athanniss/capstone-hw/bj-magistrska.step

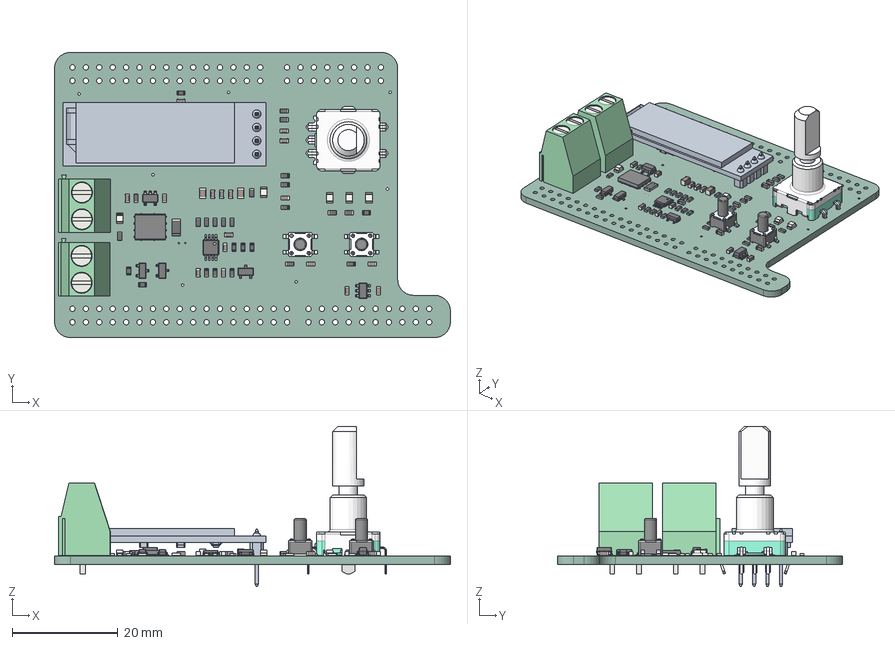
[picture p1: CAD file, 2025-01-03]
bj-magistrska.step
75.0 x 54.0 x 30.4 mm
R_0603_1608Metric x 34
TerminalBlock_Phoenix_MKDS_15_2_508_1x02_P508mm_Horizontal x 2
C_0603_1608Metric x 20
LED_0805_2012Metric x 5
L_0603_1608Metric
SOT_23_5
MSOP_8_3x3mm_P065mm x 2
PowerDI5060-8L
OLED 128 x 32 Display Assembly v4
SOT_23 x 3
R_1206_3216Metric
SOT_23_6
EC11E-15SW v3
C_0805_2012Metric x 2
PTS647SK70SMTR2LFS v2 x 2
_autosave-bj-magistrska_PCB
