athanniss/capstone-hw/bj-magistrska.kicad_pcb

## KiCad design bj-magistrska.kicad_pcb (2025-01-03)

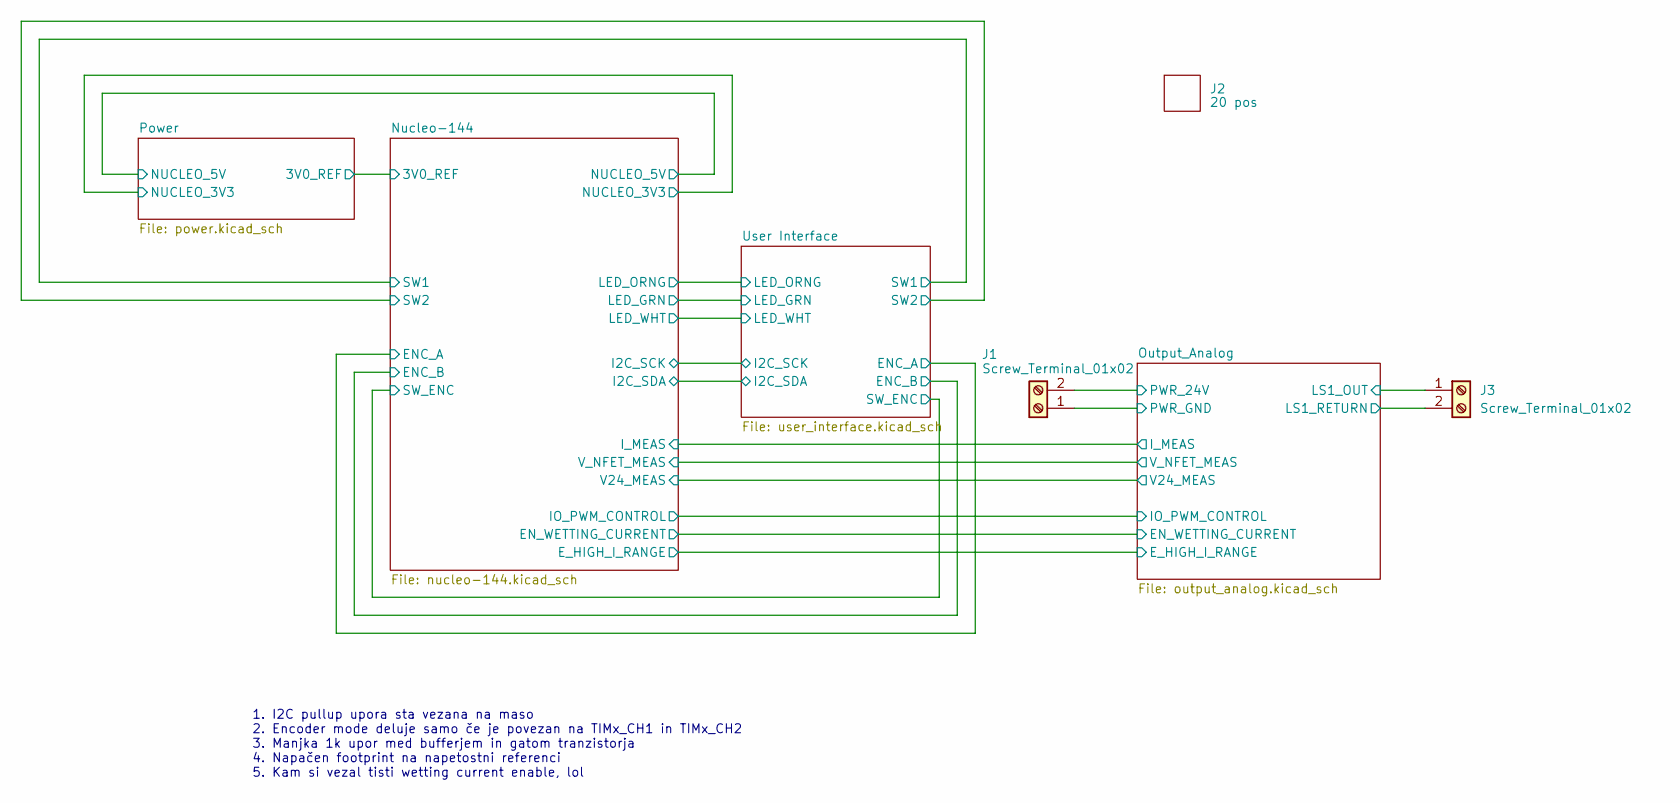
[picture p2: schematic bj-magistrska.kicad_sch]

Parts:
J1, J3: Screw_Terminal_01x02; TerminalBlock_Phoenix_MKDS-1,5-2-5.08_1x02_P5.08mm_Horizont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; Mfg. Part Number 1985904
J2: 20 pos; Mfg. Part Number PRPC020SACN-RC; Digikey no. S1131EC-20-ND

Connections:
/Output_Analog/LS1_OUT: J1.2, J3.1; also elsewhere on the board
/Output_Analog/LS1_RETURN: J3.2; also elsewhere on the board
/Output_Analog/PWR_GND: J1.1; also elsewhere on the board

Notes on the sheet:
1. I2C pullup upora sta vezana na maso 2. Encoder mode deluje samo če je povezan na TIMx_CH1 in TIMx_CH2 3. Manjka 1k upor med bufferjem in gatom tranzistorja 4. Napačen footprint na napetostni referenci 5. Kam si vezal tisti wetting current enable, lol

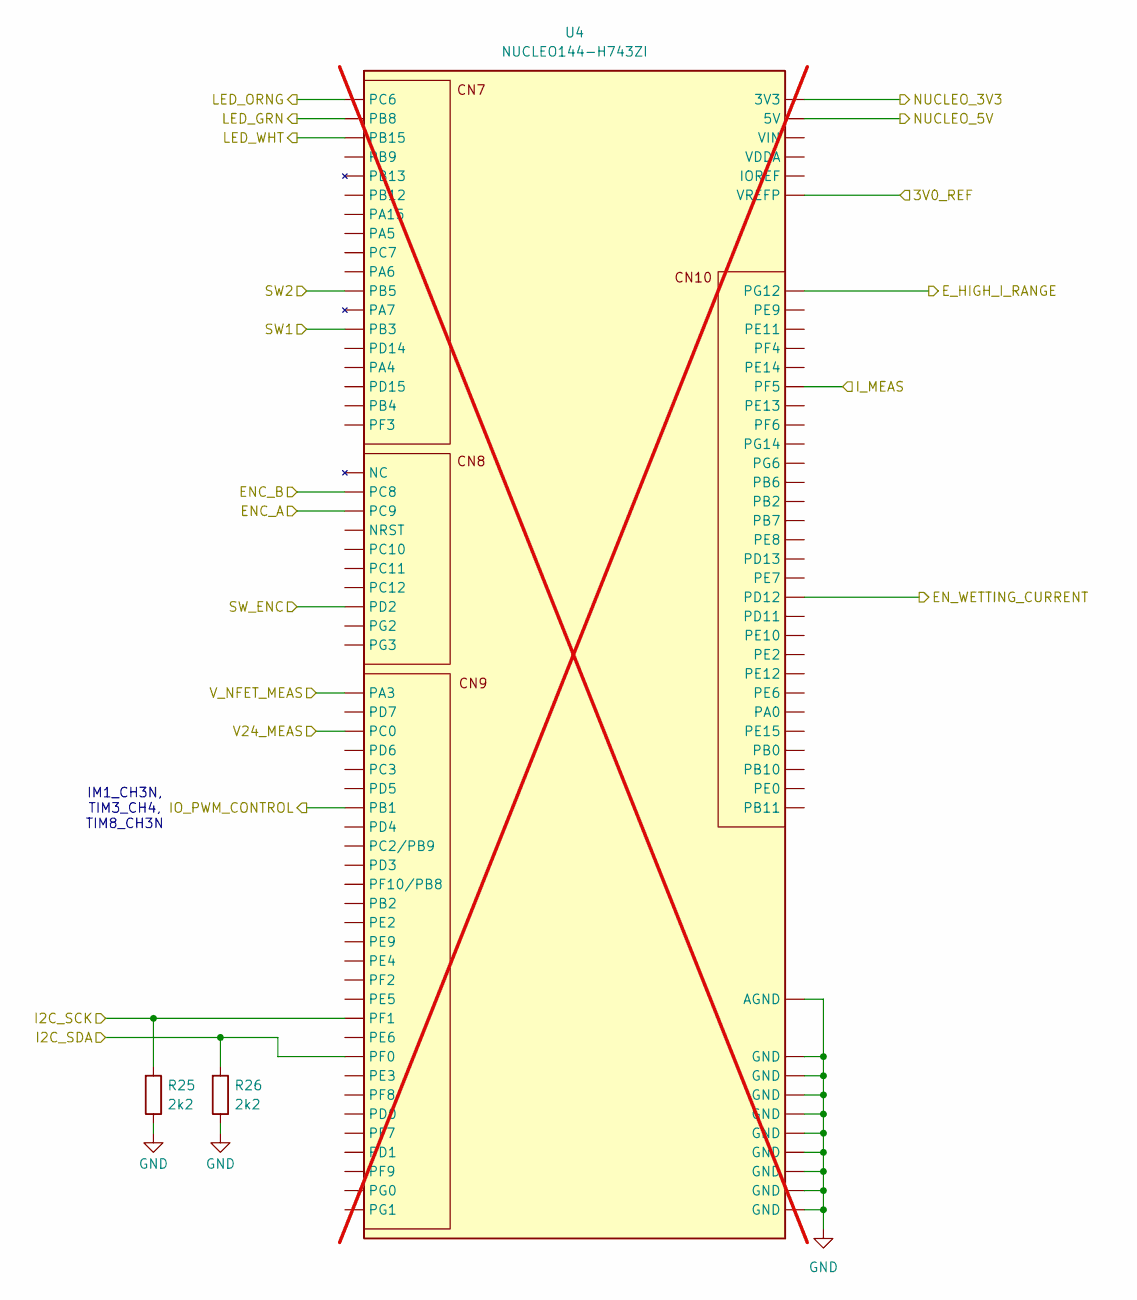
[picture p3: schematic nucleo-144.kicad_sch]

Parts:
R25, R26: 2k2; R_0603_1608Metric
U4: NUCLEO144-H743ZI; ST_Zio_Only_Connectors_144_STLink; not fitted

Connections:
+3V3: U4.CN8_7 (3V3); also elsewhere on the board
+5VD: U4.CN8_9 (5V); also elsewhere on the board
/Nucleo-144/3V0_REF: U4.CN7_6 (VREFP); also elsewhere on the board
/Nucleo-144/ENC_A: U4.CN8_4 (PC9); also elsewhere on the board
/Nucleo-144/ENC_B: U4.CN8_2 (PC8); also elsewhere on the board
/Nucleo-144/EN_WETTING_CURRENT: U4.CN10_21 (PD12); also elsewhere on the board
/Nucleo-144/E_HIGH_I_RANGE: U4.CN10_2 (PG12); also elsewhere on the board
/Nucleo-144/I2C_SCK: R25.1, U4.CN9_19 (PF1); also elsewhere on the board
/Nucleo-144/I2C_SDA: R26.1, U4.CN9_21 (PF0); also elsewhere on the board
/Nucleo-144/IO_PWM_CONTROL: U4.CN9_7 (РВ1); also elsewhere on the board
/Nucleo-144/I_MEAS: U4.CN10_9 (PF5); also elsewhere on the board
/Nucleo-144/LED_GRN: U4.CN7_2 (PB8); also elsewhere on the board
/Nucleo-144/LED_ORNG: U4.CN7_1 (PC6); also elsewhere on the board
/Nucleo-144/LED_WHT: U4.CN7_3 (PB15); also elsewhere on the board
/Nucleo-144/SW1: U4.CN7_15 (PB3); also elsewhere on the board
/Nucleo-144/SW2: U4.CN7_13 (PB5); also elsewhere on the board
/Nucleo-144/SW_ENC: U4.CN8_12 (PD2); also elsewhere on the board
/Nucleo-144/V24_MEAS: U4.CN9_3 (PC0); also elsewhere on the board
/Nucleo-144/V_NFET_MEAS: U4.CN9_1 (РАЗ); also elsewhere on the board
GND: R25.2, R26.2, U4.CN7_8 (GND), U4.CN8_11 (GND), U4.CN8_13 (GND), U4.CN9_12 (GND), U4.CN9_23 (GND), U4.CN10_3 (AGND), U4.CN10_5 (GND), U4.CN10_17 (GND), U4.CN10_22 (GND), U4.CN10_27 (GND); also elsewhere on the board

Notes on the sheet:
IM1_CH3N, TIM3_CH4, TIM8_CH3N

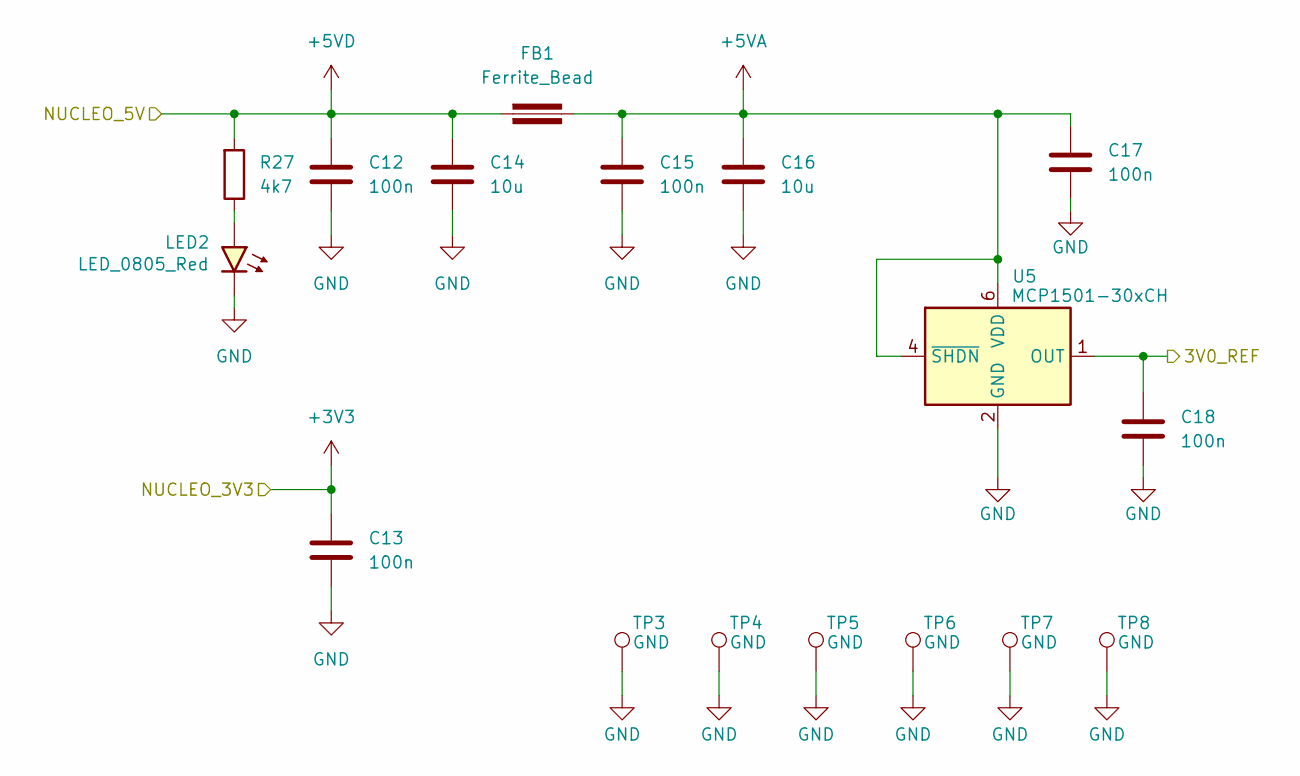
[picture p4: schematic power.kicad_sch]

Parts:
C12, C13, C15, C17, C18: 100n; C_0603_1608Metric
C14, C16: 10u; C_0805_2012Metric
FB1: Ferrite_Bead; Ferrite_0603_1608Metric
LED2: LED_0805_Red; LED_0805_2012Metric
R27: 4k7; R_0603_1608Metric
TP3, TP4, TP5, TP6, TP7, TP8: GND; TestPoint_THTPad_D1.0mm_Drill0.5mm
U5: MCP1501-30xCH; SOT-23-6; Mfg. Part Number MCP1501-30E/SN

Connections:
+3V3: C13.1; also elsewhere on the board
+5VA: C15.1, C16.1, C17.1, FB1.2, U5.4 (~SHDN), U5.6 (VDD); also elsewhere on the board
+5VD: C12.1, C14.1, FB1.1, R27.1; also elsewhere on the board
/Nucleo-144/3V0_REF: C18.1, U5.1 (OUT); also elsewhere on the board
GND: C12.2, C13.2, C14.2, C15.2, C16.2, C17.2, C18.2, LED2.1 (K), TP3.1, TP4.1, TP5.1, TP6.1, TP7.1, TP8.1, U5.2 (GND), U5.3 (GND), U5.5 (GND); also elsewhere on the board
unnamed: LED2.2 (A), R27.2

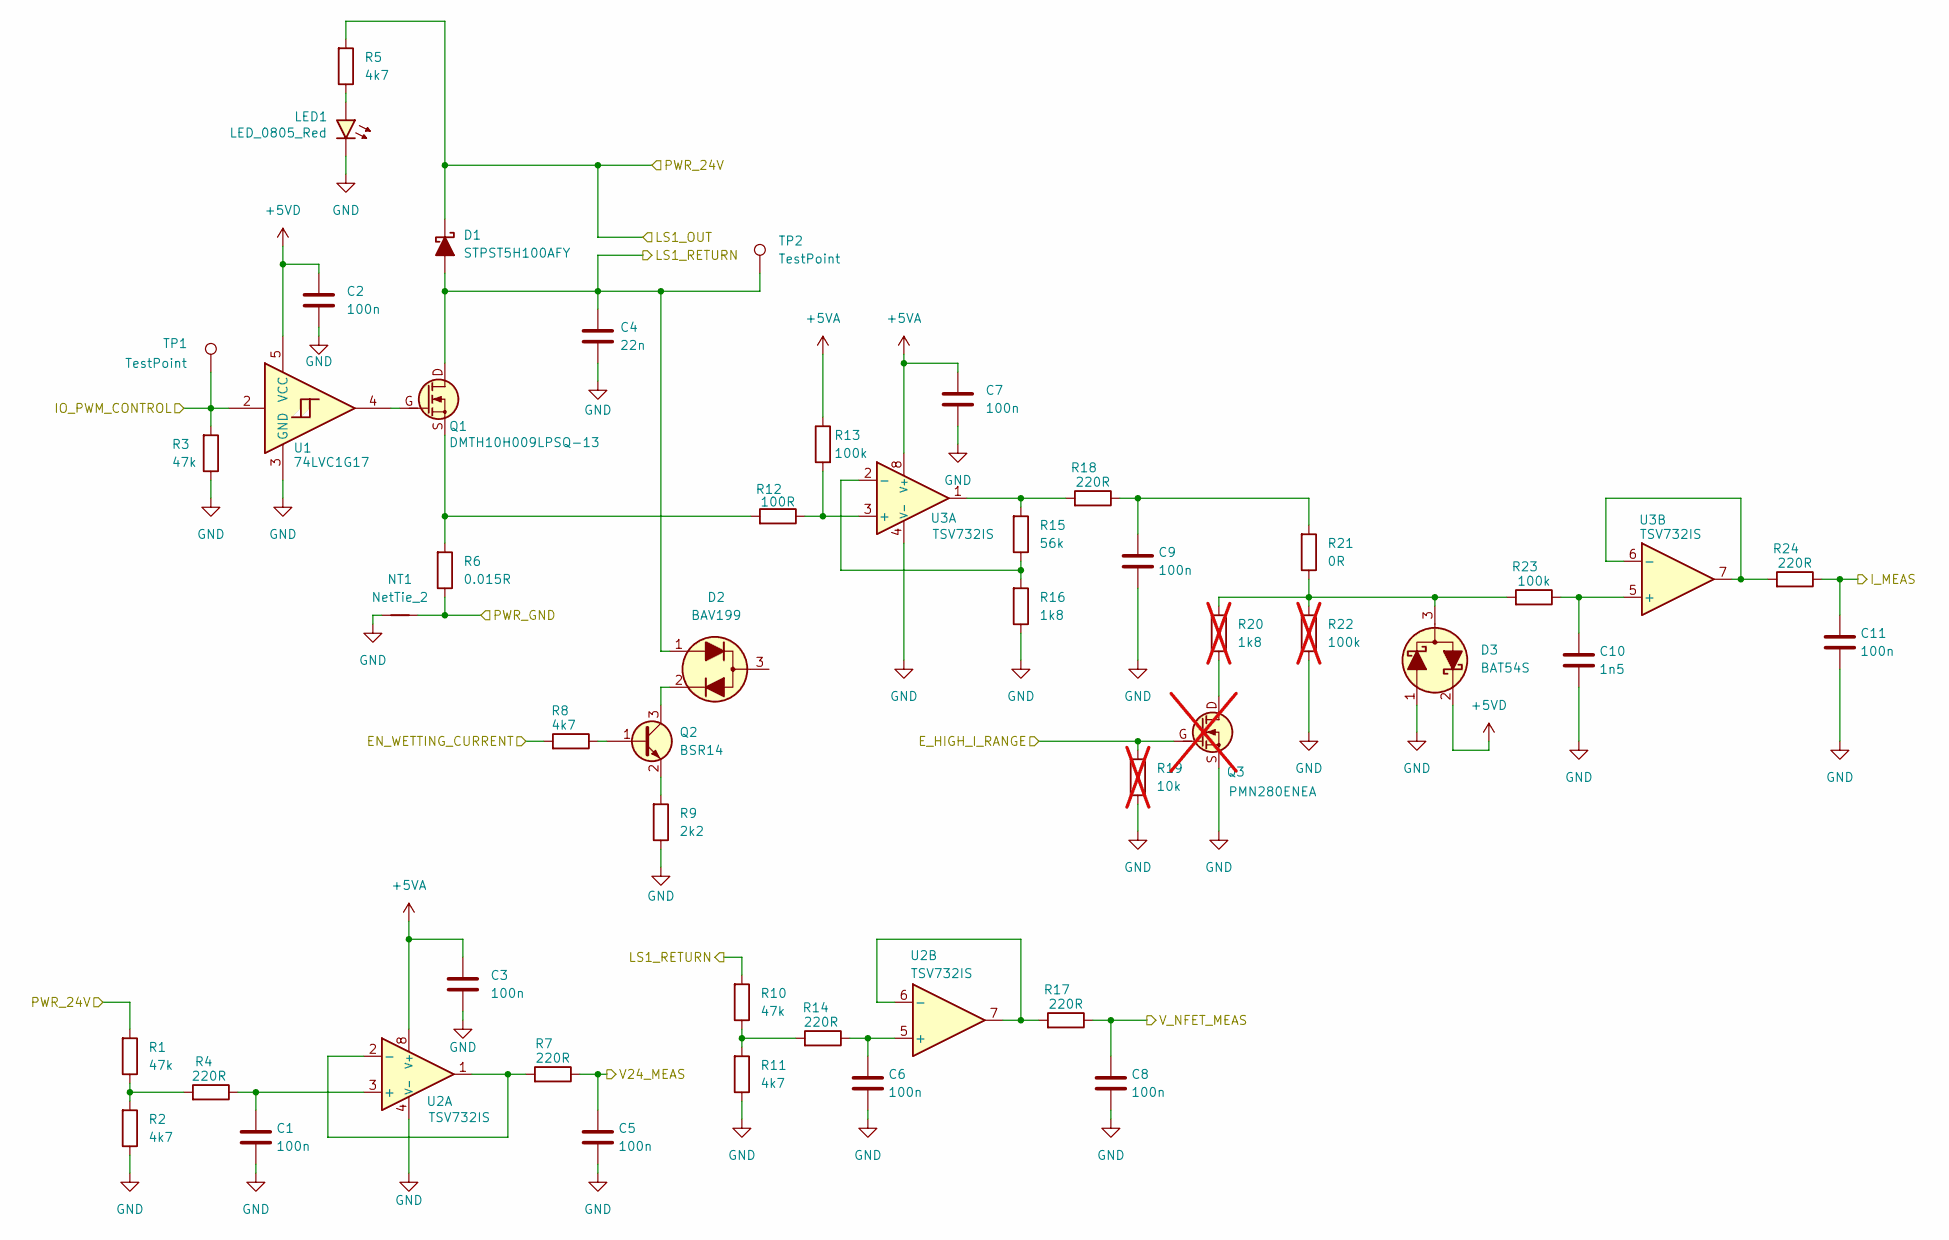
[picture p5: schematic output_analog.kicad_sch]

Parts:
C1, C2, C3, C5, C6, C7, C8, C9, C11: 100n; C_0603_1608Metric
C4: 22n; C_0603_1608Metric
C10: 1n5; C_0603_1608Metric
D1: STPST5H100AFY; D_SOD-128; Mfg. Part Number STPST5H100AFY
D2: BAV199; SOT-23; Mfg. Part Number BAV199
D3: BAT54S; SOT-23; Mfg. Part Number BAT54SHYT116
LED1: LED_0805_Red; LED_0805_2012Metric
NT1: NetTie_2; NetTie-2_THT_Pad0.3mm
Q1: DMTH10H009LPSQ-13; Diodes_PowerDI5060-8_ThermalVias; Mfg. Part Number DMTH10H009LPSQ-13
Q2: BSR14; SOT-23; Mfg. Part Number BSR14
Q3: PMN280ENEA; SC-74-6_1.5x2.9mm_P0.95mm; Mfg. Part Number PMN280ENEAX; not fitted
R1, R3, R10: 47k; R_0603_1608Metric
R2, R5, R8, R11: 4k7; R_0603_1608Metric
R4, R7, R14, R17, R18, R24: 220R; R_0603_1608Metric
R6: 0.015R; R_1206_3216Metric; Mfg. Part Number MFSA1206R0150FCM
R9: 2k2; R_0603_1608Metric
R12: 100R; R_0603_1608Metric
R13, R23: 100k; R_0603_1608Metric
R15: 56k; R_0603_1608Metric
R16: 1k8; R_0603_1608Metric
R19: 10k; R_0603_1608Metric; not fitted
R20: 1k8; R_0603_1608Metric; not fitted
R21: 0R; R_0603_1608Metric
R22: 100k; R_0603_1608Metric; not fitted
TP1, TP2: TestPoint; TestPoint_THTPad_D1.0mm_Drill0.5mm
U1: 74LVC1G17; SOT-23-5; Mfg. Part Number SN74LVC1G17DBVR
U2, U3: TSV732IS; MSOP-8_3x3mm_P0.65mm; Mfg. Part Number TSV732IST

Connections:
+5VA: C3.1, C7.1, R13.2, U2.8 (V+), U3.8 (V+); also elsewhere on the board
+5VD: C2.1, D3.2 (K), U1.5 (VCC); also elsewhere on the board
/Nucleo-144/EN_WETTING_CURRENT: R8.1; also elsewhere on the board
/Nucleo-144/E_HIGH_I_RANGE: Q3.G, R19.1; also elsewhere on the board
/Nucleo-144/IO_PWM_CONTROL: R3.1, TP1.1, U1.2; also elsewhere on the board
/Nucleo-144/I_MEAS: C11.1, R24.2; also elsewhere on the board
/Nucleo-144/V24_MEAS: C5.1, R7.2; also elsewhere on the board
/Nucleo-144/V_NFET_MEAS: C8.1, R17.2; also elsewhere on the board
/Output_Analog/LS1_OUT: D1.1 (K), R1.1, R5.1; also elsewhere on the board
/Output_Analog/LS1_RETURN: C4.1, D1.2 (A), D2.1 (A), Q1.D, R10.1, TP2.1; also elsewhere on the board
/Output_Analog/PWR_GND: NT1.2, R6.2; also elsewhere on the board
GND: C1.2, C2.2, C3.2, C4.2, C5.2, C6.2, C7.2, C8.2, C9.2, C10.2, C11.2, D3.1 (A), LED1.1 (K), NT1.1, Q3.S, R2.2, R3.2, R9.2, R11.2, R16.2, R19.2, R22.2, U1.3 (GND), U2.4 (V-), U3.4 (V-); also elsewhere on the board
unnamed: C9.1, R18.2, R21.1
unnamed: D2.2 (K), Q2.3 (C)
unnamed: D3.3 (C), R20.1, R21.2, R22.1, R23.1
unnamed: LED1.2 (A), R5.2
unnamed: Q1.G, U1.4
unnamed: Q1.S, R6.1, R12.1
unnamed: Q2.1 (B), R8.2
unnamed: Q2.2 (E), R9.1
unnamed: Q3.D, R20.2
unnamed: R1.2, R2.1, R4.1
unnamed: R10.2, R11.1, R14.1
unnamed: R15.1, R18.1, U3.1
unnamed: C1.1, R4.2, U2.3 (+)
unnamed: R7.1, U2.1, U2.2 (-)
unnamed: C6.1, R14.2, U2.5 (+)
unnamed: R17.1, U2.6 (-), U2.7
unnamed: R12.2, R13.1, U3.3 (+)
unnamed: R15.2, R16.1, U3.2 (-)
unnamed: C10.1, R23.2, U3.5 (+)
unnamed: R24.1, U3.6 (-), U3.7

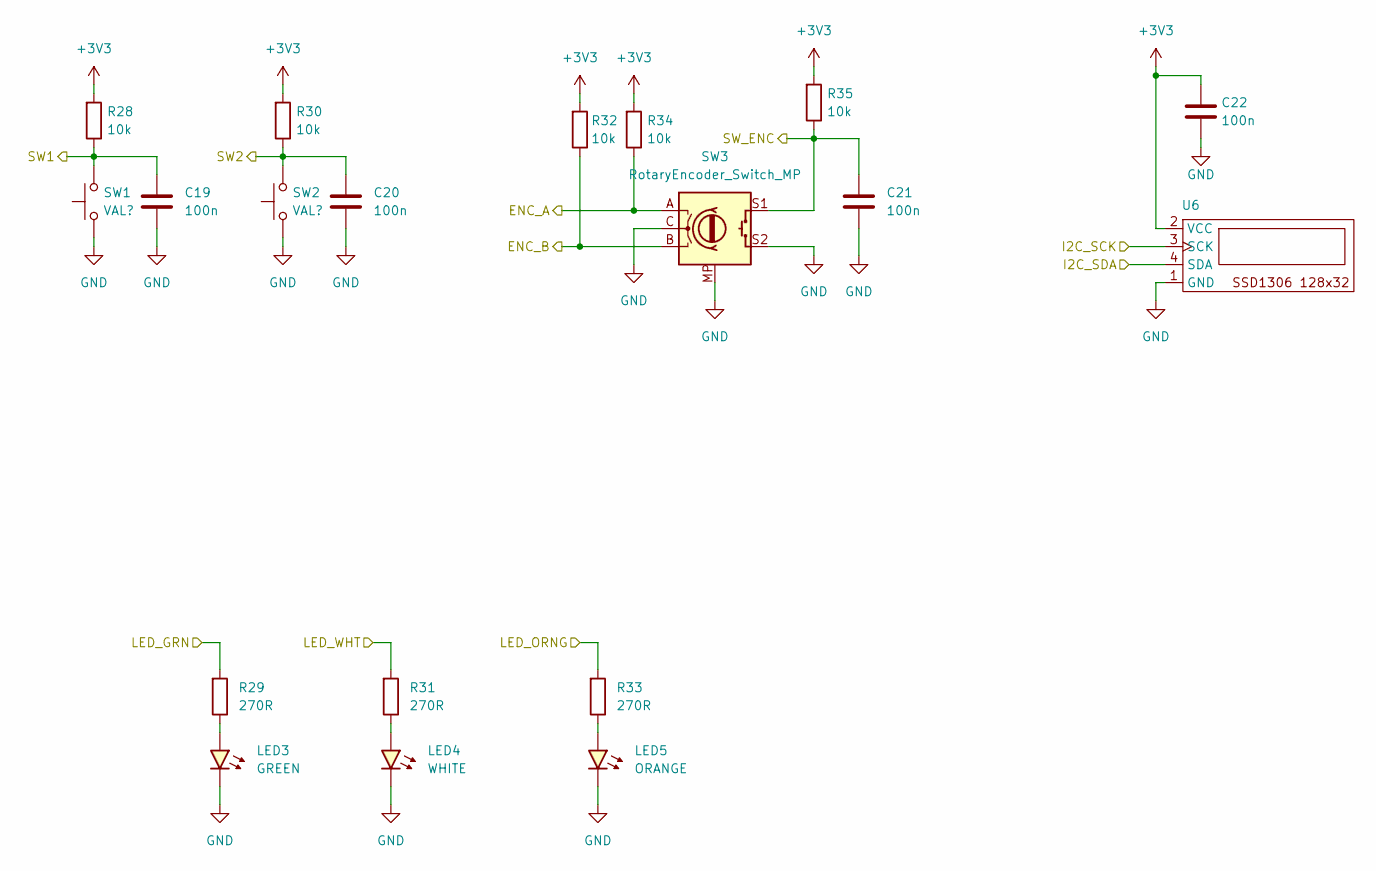
[picture p6: schematic user_interface.kicad_sch]

Parts:
C19, C20, C21, C22: 100n; C_0603_1608Metric
LED3: GREEN; LED_0805_2012Metric
LED4: WHITE; LED_0805_2012Metric
LED5: ORANGE; LED_0805_2012Metric
R28, R30, R32, R34, R35: 10k; R_0603_1608Metric
R29, R31, R33: 270R; R_0603_1608Metric
SW1, SW2: VAL?; SW_SPST_PTS647_Sx70; Mfg. Part Number PTS647SK70SMTR2LFS
SW3: RotaryEncoder_Switch_MP; RotaryEncoder_Alps_EC11E18244A5; Mfg. Part Number EC11E18244A5
U6: SSD1306-0.91-OLED-4pin-128x32_no-header-offset

Connections:
+3V3: C22.1, R28.1, R30.1, R32.1, R34.1, R35.1, U6.2 (VCC); also elsewhere on the board
/Nucleo-144/ENC_A: R34.2, SW3.A; also elsewhere on the board
/Nucleo-144/ENC_B: R32.2, SW3.B; also elsewhere on the board
/Nucleo-144/I2C_SCK: U6.3 (SCK); also elsewhere on the board
/Nucleo-144/I2C_SDA: U6.4 (SDA); also elsewhere on the board
/Nucleo-144/LED_GRN: R29.1; also elsewhere on the board
/Nucleo-144/LED_ORNG: R33.1; also elsewhere on the board
/Nucleo-144/LED_WHT: R31.1; also elsewhere on the board
/Nucleo-144/SW1: C19.1, R28.2, SW1.2; also elsewhere on the board
/Nucleo-144/SW2: C20.1, R30.2, SW2.2; also elsewhere on the board
/Nucleo-144/SW_ENC: C21.1, R35.2, SW3.S1; also elsewhere on the board
GND: C19.2, C20.2, C21.2, C22.2, LED3.1 (K), LED4.1 (K), LED5.1 (K), SW1.1, SW2.1, SW3.C, SW3.MP, SW3.S2, U6.1 (GND); also elsewhere on the board
unnamed: LED3.2 (A), R29.2
unnamed: LED4.2 (A), R31.2
unnamed: LED5.2 (A), R33.2

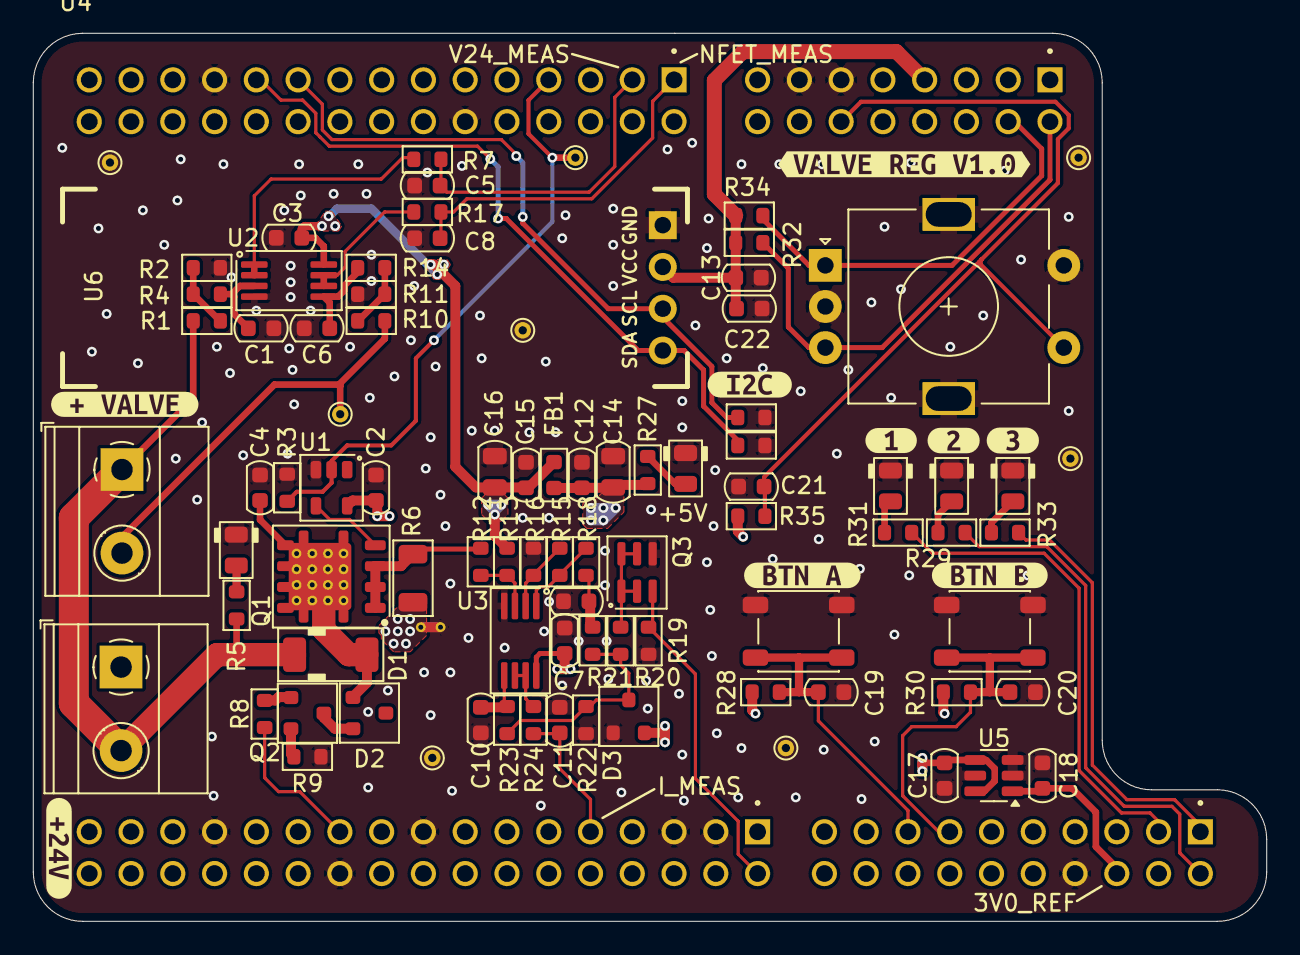
[picture p7: board bj-magistrska.kicad_pcb from above]

Board: 4 copper layers, 75.0 x 54.0 mm, 98 parts (0 on the bottom side), 48 nets.

Other parts of the board:
kibuzzard-66E6F4AB: G***; kibuzzard-66E6F4AB
kibuzzard-66E6F4D2: G***; kibuzzard-66E6F4D2
kibuzzard-66E6F4F3: G***; kibuzzard-66E6F4F3
kibuzzard-66E6F41C: G***; kibuzzard-66E6F41C
kibuzzard-66E6F48A: G***; kibuzzard-66E6F48A
kibuzzard-66E6F432: G***; kibuzzard-66E6F432
kibuzzard-66E6F459: G***; kibuzzard-66E6F459
kibuzzard-66E6F464: G***; kibuzzard-66E6F464
kibuzzard-66E6F497: G***; kibuzzard-66E6F497
